dotayush/lucknow/docs/eda_flows.md

# end to end flows: digital, analog, mixed signal

All commands assume `source ~/personal/lucknow/eda/env.sh` first. Tool locations are in `tool_paths.md`.
Process: SkyWater sky130. Wulff's blocks use `sky130B` (a few, like `lelo_*`, use `sky130A`); the LibreLane digital flow
uses `sky130A` (`sky130_fd_sc_hd` cells). Both variants come from the one PDK install.

Status marks: **[verified]** ran on this machine, **[untested]** the recommended route, not run yet.
Re-run every check with `eda/verify.sh <new empty dir>` (add `--gui` for the window checks, `--full` for the long runs).

## 0. setup and sanity

```bash
cd ~/personal/lucknow/eda
./setup.sh                      # idempotent: venv, librelane, make shim
source env.sh
make -v | head -1               # must resolve to .../eda/tools/bin/make
magic --version                 # 8.3.684
./verify.sh /media/ayush/secondary/eda/scratch/verify-$(date +%m%d%H%M)   # a new dir every time, nothing is deleted
```

`make` here is a shim that forces bash. Wulff's Makefiles use `echo -e`; under dash that writes a
literal `-e` into Tcl scripts and DRC reports a false FAIL. Without `env.sh` sourced, use `make SHELL=/bin/bash ...`.
`PDK_ROOT` has no trailing slash on purpose: `//` starts a comment for ngspice older than 40.

## 1. analog (opamps, ADCs, DACs) **[verified]**

Wulff's flow: xschem schematic, ngspice simulation, Magic layout, then DRC, LVS, extraction, post-layout sim.

```bash
cd $AICEX/ip && cicconf clone --https          # fetch the ip repos (once)
cd $AICEX/ip/<block>/work                      # e.g. rply_ex0_sky130nm; work from a copy, see the note below

xschem ../design/<LIB>/<CELL>.sch              # 1. schematic (GUI)
make xsch                                      # 2. netlist -> xsch/<CELL>.spice
magic -d 24BIT -rcfile $PDK_ROOT/sky130B/libs.tech/magic/sky130B.magicrc ../design/<LIB>/<CELL>.mag   # 3. layout (GUI)
make gds                                       # 4. gds/<CELL>.gds
make drc                                       # 5. Magic DRC: "DRC OK"
make cdl; make xlvs                            # 6. LVS vs schematic: "CORRECT" (make cdl first; xlvs without it fails)
make lpe                                       # 7. parasitics -> lpe/<CELL>_lpe.spi
make kdrc                                      # 8. optional: the PDK's KLayout rule deck, report in drc/<CELL>_drc.xml
cd ../sim/<CELL> && MPLBACKEND=Agg make typical     # 9. simulate; etc, mc, tfs for corners. VIEW=Sch or Lay
```

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

View the GDS without a GUI (renders with the PDK's layer colours):

```bash
cat > render.py <<'PY'
import pya
lv = pya.LayoutView(); lv.load_layout(gds, True); lv.load_layer_props(lyp); lv.max_hier(); lv.zoom_fit(); lv.save_image(out, 1200, 800)
PY
klayout -zz -nc -r render.py -rd gds=gds/<CELL>.gds -rd lyp=$PDK_ROOT/sky130B/libs.tech/klayout/tech/sky130B.lyp -rd out=layout.png
```

### What was checked, and what it showed

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

Caveats found while checking:

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

## 2. digital (RTL to GDSII) with LibreLane

LibreLane runs Yosys, OpenROAD, Magic (DRC, GDS), Netgen (LVS) and KLayout from a Nix store on the SSD
(`eda/nixroot`), through `bwrap`; no Docker, no root. `librelane`, `openroad`, `klayout` and `sta` on `PATH` are wrappers
around `nixrun`. Any other tool from that store: `nixrun yosys ...`, `nixrun magic ...`.

```bash
# toolchain check **[verified, native, no terminal needed]**: full flow on a tiny design, ends with "Smoke test passed."
librelane --pdk-root $LIBRELANE_PDK_ROOT --smoke-test

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

# the real run **[verified: clean DRC, LVS, antenna and XOR; timing in core/l0/librelane/RUNS.md]**
core/l0/librelane/run.sh t<N> '{"CLOCK_PERIOD": 44, "DEFAULT_CORNER": "nom_ss_100C_1v60",
  "PNR_SDC_FILE": "<repo>/core/l0/librelane/l0.sdc", "SIGNOFF_SDC_FILE": "<repo>/core/l0/librelane/l0.sdc"}'
# results: <run>/final/{gds,lef,def,nl,sdc,metrics.json} and reports for DRC, LVS, antenna, STA
core/l0/librelane/segments.sh core/l0/librelane/runs/t<N>/final    # delay of each piece of the cycle, from a finished run
core/l0/librelane/screen.sh <new_dir>                              # preview an RTL change by synthesis alone, about a minute
eda/view.sh klayout|openroad|magic <file>                          # look at a result; klayout loads the layer names and the 3D view
```

What `core/l0/librelane` holds and why (details: `RUNS.md`, `TIMING.md` there):

1. `l0_core` is the top (memories outside, ports for fetch and data). A core with no outputs synthesizes to nothing.
2. `l0.sdc` replaces the flow's generic constraint (20% of the clock on every port), which hides the real path. It models the memory as an
   access time and cuts the cycle at the ports.
3. `config.json`: `DESIGN_NAME`, `VERILOG_FILES`, `CLOCK_PORT`, `CLOCK_PERIOD`, utilisation, and the cells kept out of buffering.
4. each run is stored on the SSD and linked into `runs/`; once recorded in `RUNS.md` its folder is deleted (about 1.8 GB each).

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

## 3. mixed signal **[verified up to signoff; see the result below]**

A real analog block (`LELO_GR02`, the oscillator from `lelo_gr02_sky130a`) was placed as a macro in a small digital design
and taken through LibreLane. The working files are in `/media/ayush/secondary/eda/scratch/ms-demo/design`
(`ms_demo.v`, `config.json`, `pdn_cfg.tcl`, the macro `.gds` and `.lef`).

```bash
# 1. analog block, from its work/ directory (so its .magicrc is used): lef and gds
#    load ../design/<LIB>/<CELL>.mag ; lef write <CELL>.lef -hide ; gds write <CELL>.gds
magic -noconsole -dnull export.tcl

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

# 3. digital top with the macro as a blackbox (signal pins only), config.json with MACROS, PDN_MACRO_CONNECTIONS,
#    DIE_AREA, then:
librelane --pdk-root $LIBRELANE_PDK_ROOT --pdk sky130A --run-tag ms config.json
```

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

**Result [verified]:** `ms_demo` (330 x 260 um, 15.9k cells incl. fill, a counter that powers up the oscillator and a
synchroniser that counts its output) closes with every signoff count at 0: Magic DRC 0, KLayout DRC 0, LVS errors 0
(device and net differences 0), antenna 0, routing DRC 0, Magic/KLayout streamout XOR 0, setup and hold violations 0 at a
50 ns clock (worst setup slack +37 ns, hold +0.11 ns). The final GDS has the analog macro inside it.
Everything above is scripted in `eda/ms_demo/run.sh <new_dir>` (about 10 minutes).

Two things that went wrong first, and are worth knowing:

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

## 4. housekeeping

```bash
df -h / /home /media/ayush/secondary   # keep / above 5 GB
```

Run each check in a new directory under `/media/ayush/secondary/eda/scratch`; do not delete run directories to save
space without asking (a standing rule: no recursive deletes).
