dotayush/lucknow/soc/k0/docs/CHIP.md

# k0

A small RISC-V system on a chip (SoC): the l0 core grown into RV32IMA, a memory bus with a
boot rom, ram and three peripherals (uart, clint, plic), and machine interrupts. Still
single-hart, machine mode only, work in progress. The platform deliberately mimics QEMU's
`virt` machine, so software written for that board finds the same devices at the same
addresses.

## Words used below

| word | meaning |
|---|---|
| RV32IMA + Zicsr | base integer set, **M** multiply/divide, **A** atomics, and CSR instructions |
| hart | a hardware thread: one core's instruction stream. k0 has one (`mhartid = 0`) |
| M-mode / U-mode | machine mode, the highest privilege level, and user mode, the lowest. k0 has these two (no supervisor mode) |
| CSR | control and status register, a numbered core register such as `mtvec` |
| trap | the core abandons the current instruction and jumps to a handler. An *exception* is caused by the instruction, an *interrupt* by something outside |
| `mepc` / `mcause` / `mtval` / `mtvec` | where to resume / why / extra detail (bad address or instruction) / where the handler is. `mcause` bit 31 set means interrupt |
| `mie` / `mip` / `mstatus.MIE` | interrupt-enable bits per source / interrupt-pending bits per source / global interrupt enable |
| `mret` | return from a trap handler |
| CLINT | core-local interruptor: a timer and a software-interrupt flag, per hart |
| PLIC | platform-level interrupt controller: collects device interrupt lines, ranks them, hands one to the hart |
| UART | serial port. The register layout is that of the 16550 chip that Linux's 8250 driver expects |
| AMO | atomic memory operation: read, modify, write memory as one indivisible step |
| LR / SC | load-reserved / store-conditional: an optimistic atomic pair, SC fails if something else wrote the word in between |
| MMIO | memory-mapped I/O: device registers accessed with ordinary loads and stores |
| wait state | extra clocks a memory takes to answer; the core freezes meanwhile |
| earlycon | Linux's minimal console driver used before the real serial driver loads |

## At a glance

- RV32IMA + Zicsr, machine and user mode, no C (compressed), no F/D, no Zifencei-specific hardware (`fence.i` works because code and data share ram).
- Single-issue, in order, non-pipelined: one instruction at a time, **one clock per instruction** when memory answers immediately. Loads and stores that hit slow memory, and AMOs (two transfers), take more.
- Fully synchronous apart from async active-low reset (`rst_n`).
- Reset vector `0x0000_1000` (the boot rom).

## Memory map

| range | size | what | access |
|---|---|---|---|
| `0x0000_1000` | 4 KiB (`ROM_WORDS`=1024) | boot rom, preloaded from `memory/bootrom.hex` | read only; fetch and load |
| `0x0200_0000` | 64 KiB | CLINT | word, data port only |
| `0x0C00_0000` | 64 MiB window | PLIC | word, data port only |
| `0x1000_0000` | 256 B | UART (8 registers, repeated) | byte, data port only |
| `0x8000_0000` | `RAM_WORDS` words, default 8192 = 32 KiB | ram | byte/half/word, fetch and data |

Everything else is an access fault. So is: a store to the rom, a non-byte access to the
uart, a non-word or misaligned access to the clint or plic, and fetch from anywhere
but rom or ram. The boot rom holds four instructions: `a1` = `0x807F_0000` (where the device tree goes, low in a 16 MiB ram so it stays out of the way), `a0` = 0 (hart id), jump to `0x8000_0000`; the program
image is preloaded into ram with `RAM_INIT` (a `$readmemh` hex file, one word per line).
This is how every test and program starts: there is no loader or flash yet.

The instruction port and the data port see the *same* ram array, so a store is visible to
the next fetch. `memory/bootrom.hex` is only 4 words; the rest of the rom reads 0.

## Instructions

- **RV32I** as in l0 (see `core/l0/docs/CHIP.md`), plus:
- **M**: `mul mulh mulhsu mulhu div divu rem remu`. The four multiplies are combinational in the ALU, in one clock, through one 33 bit
  signed multiplier. The four divides run in `core/divider.sv`, one quotient bit per clock (restoring divider on the absolute values,
  signs fixed at the end), and hold the core with `stall` like a slow memory: **a divide takes 34 clocks** (1 to load the operands,
  32 for the bits, 1 to retire). Division by zero (`x / 0` = all ones, `x % 0` = x) and overflow (`min int / -1` = min int, remainder 0)
  follow the spec. An interrupt arriving while a divide runs is taken at once: the divide is abandoned (nothing was written) and runs again
  after `mret`, like the atomics. Why: the single-cycle `/` and `%` were 66 ns of a 83 ns ideal-wire path, and the arrays of one
  multiplier and one divider per instruction did not get through logic synthesis (`librelane/RUNS.md`).
- **A**: `lr.w`, `sc.w` and `amoswap/add/xor/and/or/min/max/minu/maxu.w`.
  - Word only (`f3 = 010`); `.aq/.rl` bits are accepted and ignored (nothing reorders).
  - `lr.w` takes a one-word reservation. It is cleared by any store, any `sc`/AMO, a trap and `mret`.
  - `sc.w` succeeds (writes 0 to rd) only if the reservation is on the same address, otherwise writes 1 and stores nothing.
  - An AMO is two bus transfers (read, then write) of one instruction. An interrupt cannot land between them: the whole AMO is restarted after `mret`.
  - Misaligned `sc`/AMO traps even when `sc` would have failed.
  - Reported as a *load* fault for `lr`, a *store* fault for `sc` and the AMOs.
- `wfi` is a no-op (the core keeps running, software loops around it). In user mode it is an illegal instruction.
- `fence` is a no-op; `fence.i` is a no-op that is correct because fetch always sees the latest store.

## Traps

Exceptions use the same codes as l0 (0..7 and 11, see the l0 doc). The extra ones are the
**interrupts**, taken *between* instructions: the interrupted instruction does nothing at all
(no write, no memory transfer, `mepc` is its own pc) and is run again after `mret`.

| `mcause` | interrupt | source |
|---|---|---|
| `0x8000_000B` | machine external | PLIC (`mip.MEIP`, bit 11) |
| `0x8000_0003` | machine software | CLINT `msip` (`mip.MSIP`, bit 3) |
| `0x8000_0007` | machine timer | CLINT `mtime >= mtimecmp` (`mip.MTIP`, bit 7) |

- Priority when several are pending and enabled: external, then software, then timer.
  Exceptions are never masked.
- An interrupt is taken when `mstatus.MIE` is set and `mie & mip` is non-zero.
- Handler address: `mtvec` bit 0 = 0 *direct* (everything to the base), 1 *vectored*
  (interrupts to `base + 4 * code`, exceptions still to the base).
- Trap entry: `mstatus.MPIE = MIE`, `MIE = 0`, `MPP` = the mode the trap came from, the hart enters machine mode.
  `mret`: `MIE = MPIE`, `MPIE = 1`, the hart goes to the mode in `MPP`, `MPP = 00` (user).

### Privilege

- Two modes: machine (`MPP` = `11`) and user (`00`). Reset is machine mode. `MPP` is WARL: any other value reads `00`.
- No physical memory protection: user mode may access everything the machine can (the kernel of a
  no-MMU system trusts its tasks). `pmpaddr*`/`pmpcfg*` are plain storage.
- In user mode, an *illegal instruction* exception is raised by: any csr whose address bits 11:10 are `11`
  *and* is written, any csr of a higher level (address bits 9:8 not `00`: everything `mstatus`, `mtvec`, `mepc`...),
  `cycle/time/instret(h)` unless the matching bit of `mcounteren` is set, `mret` and `wfi`.
- Writing a read only csr (address bits 11:10 = `11`, with a csr instruction that actually writes) is illegal
  in every mode.
- `ecall` from user mode is cause 8, from machine mode 11.
- Interrupts for machine mode are always enabled while the hart is in user mode, whatever `mstatus.MIE` says.
- A trapping or stalled instruction does not retire.
- Inside `control.sv` the one trap that follows the branch compare (a taken branch to a target that isn't 4 byte aligned) is kept
  apart from the others (`trap_early`): the register file and the CSRs a trap does not touch use `trap_early` only, and the late
  decision reaches only `next_pc` and the trap record (`mepc`, `mcause`, `mtval`, `mstatus`). Behaviour is the same, as in l0. The
  branch events of the performance counters read the branch decision (`br_taken`) directly.

## CSRs

As in l0, only the CSRs below exist, each as a named register in `csrfile.sv` (the counters, `pmpcfg*`/`pmpaddr*` and
`mcountinhibit` are described with their own features). Any other address reads 0 and ignores writes, without trapping
(`medeleg`, `mideleg` and `satp` for example). Where behaviour exists:

| CSR | address | notes |
|---|---|---|
| `mstatus` | 0x300 | `MIE` (3), `MPIE` (7) and `MPP` (12:11, `00` or `11`) are writable. Everything else reads 0 |
| `misa` | 0x301 | `0x4010_1101`: RV32, I, M, A, U. Read only |
| `mscratch` | 0x340 | plain storage |
| `mcounteren` | 0x306 | plain storage, bits 0..2 gate `cycle`, `time`, `instret` in user mode |
| `mie` | 0x304 | writable bits 3, 7, 11 only |
| `mtvec` | 0x305 | bit 1 forced to 0; mode = bit 0 |
| `mepc` `mcause` `mtval` | 0x341..0x343 | written on traps |
| `mip` | 0x344 | read only: it *is* the three input wires |
| `mcycle(h)` | 0xB00 / 0xB80 | 64-bit, +1 per clock (includes stall clocks). Writable |
| `minstret(h)` | 0xB02 / 0xB82 | 64-bit, +1 per retired instruction. Writable |
| `cycle(h)` `instret(h)` | 0xC00.. | read-only aliases |
| `time(h)` | 0xC01 / 0xC81 | read from the CLINT's `mtime` |
| `mvendorid` `marchid` `mimpid` `mhartid` | 0xF11..0xF14 | zero, read only |

A write to either half of a 64-bit counter replaces the whole counter.
Writes to read-only CSRs are dropped without trapping.

## Devices

### UART (`0x1000_0000`)
16550A: 16550 register layout with a 16 byte receive and transmit FIFO, enabled by `FCR` bit 0
(`FCR` is the write side of register 2; FIFO = first-in first-out queue). With the FIFOs off it behaves as a 16450,
one byte each way. Use `compatible = "ns16550a"` in a device tree. Byte accesses only. Fixed 8N1 at
`clk / UART_CLKS_PER_BIT` (default 8, minimum 4); the divisor latches (`DLAB`) are stored but
do not change the baud rate.

| offset | read | write |
|---|---|---|
| 0 | `RBR` received byte (clears DR) | `THR` send a byte; with FIFOs off dropped if still sending, with FIFOs on queued (16 deep) |
| 1 | `IER` | `IER`: bit 0 rx data, 1 THR empty, 2 line status |
| 2 | `IIR`: 0x01 none, 0x06 line status, 0x04 rx data (at the trigger level), 0x0C character timeout, 0x02 THR empty (reading clears 0x02); bits 7:6 = 11 with FIFOs on | `FCR`: bit 0 FIFO enable, 1 clear rx, 2 clear tx, 7:6 rx trigger 1/4/8/14 |
| 3, 4, 7 | `LCR`, `MCR`, `SCR` stored only | |
| 5 | `LSR`: bit 0 DR (rx FIFO not empty), 1 overrun, 3 framing, 5 THRE (tx FIFO empty), 6 TEMT (nothing queued or shifting) (OE, FE clear on read) | |
| 6 | `MSR` = 0 | |

An overrun keeps the unread byte and drops the new one. Software has to drain the receiver
within one byte time. `ECHO=1` prints transmitted bytes in simulation. Interrupt is PLIC source 10.

### CLINT (`0x0200_0000`, sifive/qemu layout, one hart)
| offset | register |
|---|---|
| `0x0000` | `msip`: bit 0 is the software interrupt |
| `0x4000` / `0x4004` | `mtimecmp` low / high (resets to all ones: no timer interrupt until set) |
| `0xBFF8` / `0xBFFC` | `mtime` low / high, a 64-bit counter of clocks since reset (writable) |

Timer interrupt is level: high while `mtime >= mtimecmp`. Clear it by moving `mtimecmp` forward.

### PLIC (`0x0C00_0000`, sifive/qemu layout, one context = this hart's M-mode)
| offset | register |
|---|---|
| `0x000000 + 4n` | priority of source n (3 bits, 0 = never interrupts), n = 1..31 |
| `0x001000` | pending bits (read only) |
| `0x002000` | enable bits |
| `0x200000` | threshold: only priorities strictly above it interrupt |
| `0x200004` | read = claim (id of the best pending source, 0 if none), write = complete (write the id back) |

Sources are level-triggered. A claimed source stays blocked until completed, so a device that
is still asserting does not re-interrupt before the handler is done. Highest priority wins,
lowest id on a tie. Only the UART is connected (source 10).

## Bus and timing

`bus.sv` decodes addresses and also owns the timing model.

- Fetch port and data port are independent request/ready channels. The core presents an
  address and waits for `ready`; the transfer completes on the clock edge where both are high.
- `FETCH_WAIT` and `DATA_WAIT` add that many clocks to every *new* request, to test the core
  against slow memory. While waiting the whole core freezes: pc, registers, CSRs and memory
  are untouched, so an instruction happens exactly once.
- Device registers with side effects (UART `RBR/LSR/IIR`, PLIC claim) act only on the clock
  where the access completes, never on waiting clocks.
- Ram and rom reads are combinational; ram writes land on the completing edge.

## Files

| file | role |
|---|---|
| `core/control.sv` | the core: datapath, A-extension sequencing, interrupts, stalls, trap selection. Loads, stores and `jalr` compute `rs1 + imm` on their own adder, not through the alu |
| `core/decoder.sv` `alu.sv` `regfile.sv` `signext.sv` | as in l0; the ALU also does the four multiplies |
| `core/divider.sv` | div, divu, rem, remu: one bit per clock, started and held by `control.sv` through `stall` |
| `core/csrfile.sv` | CSRs, interrupt pending/enable logic, 64-bit counters |
| `core/cache.sv` | despite the name, a plain ram/rom array with a second read-only fetch port |
| `core/clint.sv` `plic.sv` `uart.sv` | the devices |
| `bus.sv` | address decode, wait states, device wiring |
| `core/soc.sv` | core + bus: ports `clk`, `rst_n`, `uart_rx`, `uart_tx` |
| `core/shared.sv` | package `isa_shared`: opcodes, ALU ops, CSR addresses, trap codes |
| `compile.f` | file list for iverilog |

## Verification

- `tests/test_<module>.sv` per unit (alu, bus, clint, control, csrfile, decoder, memory,
  plic, regfile, signext, uart) plus `test_amo_faults.sv`.
- `riscv/run.sh`: official riscv-tests rv32ui (including `fence_i`), rv32mi (including
  `illegal`, `instret_overflow`), rv32um and rv32ua (suite cloned into `core/l0/riscv-tests` on first use; needs
  `riscv32-unknown-elf-gcc`, `source eda.sh` puts it on `PATH`). Works with wait states, 2 cycles per fetch and 3 per data access:
  `RV_IFLAGS="-Ptest_riscv.FETCH_WAIT=2 -Ptest_riscv.DATA_WAIT=3" ./riscv/run.sh`.
- `programs/run.sh <name>`: bare-metal assembly programs run through the uart, output compared with `<name>.expect`:
  `hello` (the default), `timer` (CLINT interrupts, direct and vectored), `irqatomic` (AMOs hit by
  interrupts are neither lost nor repeated), `uartrx` (typed bytes arrive by PLIC interrupt, echoed upper case), `umode`.
  Slow memories: `IFLAGS="-Ptest_hello.FETCH_WAIT=2 -Ptest_hello.DATA_WAIT=3" ./programs/run.sh irqatomic`. The uart input follows
  with 2 bit times between bytes; `IFLAGS="-Ptest_hello.RX_GAP=0"` sends them back to back, and with slow memories the handler can't
  keep up with a uart in 16450 mode (that program does not enable the fifo): bytes are lost (overrun), which is what the hardware should do.
- Not run: `breakpoint` (debug triggers) and `ma_data` (hardware misaligned access).

## Performance counters (Zihpm)

Besides `cycle`, `time` and `instret`, eight event counters: `mhpmcounter3..10` (64 bit, high halves at
`mhpmcounter3h..`), each counting the one event named by its `mhpmevent3..10` register. Event 0 counts
nothing, numbers above 15 read back as 0. `mcountinhibit` stops counters: bit 0 cycle, bit 2 instret,
bits 3 to 10 the event counters. Counters 11 to 31 are not there (read zero, writes ignored).

| event | counts | | event | counts |
|---|---|---|---|---|
| 1 | loads retired | | 9 | clocks waiting for data (bus not ready) |
| 2 | stores retired | | 10 | multiply and divide retired |
| 3 | conditional branches taken | | 11 | atomics retired |
| 4 | conditional branches not taken | | 12 | CSR instructions retired |
| 5 | jumps retired (`jal`, `jalr`) | | 13 | clocks in user mode |
| 6 | exceptions taken | | 14 | access faults taken (bus or PMP) |
| 7 | interrupts taken | | 15 | misaligned access traps |
| 8 | clocks waiting for the instruction | | | |

- At reset counters 3 to 10 count events 1 to 8 (loads, stores, taken, not taken, jumps, exceptions,
  interrupts, fetch wait clocks), and `mcounteren` allows user mode to read every counter. Both are
  conveniences: the Linux M-mode build never writes `mcounteren`, so without them user programs could not
  read the counters. Reprogram the events with a `csrw` in machine mode.
- `hpmcounter3..` (0xC03..) are the user mode read-only copies, gated per counter by `mcounteren`.
- Counts are global: whoever runs between two reads is included, the kernel too.
- Test: `programs/hpm.S` counts a known workload and checks inhibit, the 64 bit carry and user access.

## PMP (physical memory protection)

Eight regions, checked on every instruction fetch and data access (`core/pmp.sv`, registers in
`csrfile.sv`: `pmpcfg0`/`pmpcfg1`, `pmpaddr0`..`pmpaddr7`; entries 8 to 15 read as zero).

| `pmpcfg` bit | meaning |
|---|---|
| 0 R, 1 W, 2 X | read, write, execute allowed |
| 4:3 A | 0 off, 1 TOR (top of range: from the previous entry's address up to this one), 2 NA4 (one 4 byte word), 3 NAPOT (naturally aligned power of two, size from the trailing ones of `pmpaddr`) |
| 7 L | locked: the entry also binds machine mode, and its `pmpcfg` byte and `pmpaddr` (and the `pmpaddr` below a locked TOR) ignore writes until reset |

- The lowest numbered matching entry decides. User mode needs a match with the right permission, and fails
  if nothing matches. Machine mode passes if nothing matches or the match is not locked.
- A failing fetch is instruction access fault (1), a failing load or `lr` is load access fault (5), a
  failing store, `sc` or amo is store access fault (7). The access is not sent to the bus at all.
- Granularity is 4 bytes. `W` without `R` is reserved and `W` is dropped on write.
- Linux in M-mode only programs entry 0 as "everything, rwx" (`head.S`) so it runs, and protects nothing.
  Making user tasks unable to write kernel memory needs kernel support that sets regions per task.
- Test: `tests/test_pmp.sv` (the checker) and `programs/pmp.S` (user mode against regions, locked entries).

## Not implemented

- S-mode, `medeleg`/`mideleg`, `sret`, `mstatus` bits other than `MIE`/`MPIE`/`MPP` (`MPRV`, `SUM`...).
- MMU, `satp`, page tables, `sfence.vma`; PMP entries 8 to 15 and `mstatus.MPRV` (see PMP).
- C (compressed) and F/D; hardware misaligned loads/stores (they trap).
- Debug module and triggers, `mcountinhibit`, `mconfigptr`.
- More than one hart, more than one PLIC context, per byte error flags in the UART FIFO.
- Any storage device, timer other than CLINT, interrupt sources other than the UART.
- Ram is small by default (32 KiB). Raise `RAM_WORDS` for anything larger.

## Running Linux

k0 boots a no-MMU Linux 6.12 (M-mode kernel build, `CONFIG_RISCV_M_MODE`, user tasks in user mode)
to a busybox shell on the uart. Everything for this is in `linux/` and `sim/`; how to build and run it is in
`LINUX.md`, the plan and findings in `PLAN.md`.

- `sim/build.sh` builds a Verilator model of the soc with 16 MiB of ram. `sim/obj/Vsoc` loads binary
  images into ram, drives the uart receive line from a file and prints what the uart sends. Roughly
  1.7 million instructions per second of host time.
- `linux/build.sh` builds the kernel, the device tree (`k0.dts`) and a small freestanding `init` with a
  shell (`init/init.c`, a bFLT binary, no libc). `linux/run.sh` boots it, `linux/test.sh` boots it and types commands.
  `linux/buildroot/` builds a busybox and uClibc-ng root filesystem, `linux/busybox.sh` embeds it, `linux/shell.sh` puts
  your terminal on the uart, `linux/qemu.sh` runs the same image on QEMU as a reference.
- The kernel needs: `a0` = hart id and `a1` = device tree pointer (the boot rom does that), ram at
  `0x8000_0000`, the kernel linked there, the uart as `ns16550a`, CLINT, PLIC, `timebase-frequency`
  equal to the clock (`mtime` counts clocks). Misaligned loads/stores trap and are emulated by the kernel.
