dotayush/lucknow/core/l0/librelane/RUNS.md

# l0_core LibreLane runs

One row per try that finished or taught something: settings, results, outcome. The model behind the numbers is in
`TIMING.md`. `results/t<N>.metrics.json` is the flow's final `metrics.json` for each finished run. Run folders are
about 1.8 GB each, live under `$EDA/scratch/l0-try<N>/runs/t<N>`, are linked as `runs/t<N>` while they exist,
and are deleted once recorded here (`run.sh` starts a run, `segments.sh` measures one, `screen.sh` previews an RTL change).

Common to every run: design `l0_core`, sky130A, `sky130_fd_sc_hd`, LibreLane 3.0.16, full flow, flip-flops 1408
(register file 1024, 11 CSRs 352, pc 32). `FP_CORE_UTIL` 40 and `PL_TARGET_DENSITY_PCT` 50 unless stated; die 254,154 um2
(about 504 um square). Slack is setup slack at signoff on extracted wires; `ss` is `max_ss_100C_1v60`, `tt` is
`nom_tt_025C_1v80`. Cell area is placed standard cells including taps, repair and clock buffers. Signoff = Magic DRC,
KLayout DRC, routing DRC, LVS, antenna and layout XOR; "clean" means all six are 0. Hold violations are 0 in every finished run.

## Settings

| try | question | change from the previous row | clock (ns) | optimized corner | constraints |
|---|---|---|---|---|---|
| t3 | does the trimmed core build | CSR file trimmed to 11 registers | 50 | tt | fallback SDC |
| t4 | do delay cells cost timing | `EXTRA_EXCLUDED_CELLS`: `clkdlybuf*`, `dlymetal*` | 50 | tt | fallback SDC |
| t5 | does the optimized corner matter | slow corner | 50 | ss | fallback SDC |
| t6 | does a tighter clock help | clock 38 | 38 | ss | fallback SDC |
| t7 | is the wire layer estimate the gap | `SIGNAL_WIRE_RC_LAYERS` met1, met2 | 38 | ss | fallback SDC |
| t8 | how far does the resizer go | clock 29 | 29 | ss | fallback SDC |
| t9 | does a setup margin close it | clock 36, setup margins 7 ns | 36 | ss | fallback SDC |
| t11 | which block owns the path | `SYNTH_HIERARCHY_MODE: keep`, `ERROR_ON_UNMAPPED_CELLS: false` | 36 | ss | fallback SDC |
| t14 | realistic constraints | `l0.sdc` (memory 4 ns, budgets 6 and 10 ns), default margins | 44 | ss | `l0.sdc` |
| t16 | does shorter wiring help | t14 plus `FP_CORE_UTIL` 55, density 65 | 44 | ss | `l0.sdc` |
| t17 | where do the hold buffers come from | t14 repeated | 44 | ss | `l0.sdc` |
| t18 | does splitting the trap help | RTL: trap split into early and late parts, t17 settings | 44 | ss | `l0.sdc` |
| t19 | does a dedicated address adder help | RTL: `rs1 + imm` for loads, stores and `jalr` on its own adder, t18 settings | 44 | ss | `l0.sdc` |
| t20 | does taking decode out of the register read and the address help | RTL: register file reads `instruction[19:15]` and `[24:20]` (not the decoder's gated `rs1`/`rs2`), `dmem_addr` is the adder output without opcode selection, adder offset from the instruction bits, t19 settings | 44 | ss | `l0.sdc` |
| t21 | (IHP SG13G2, unscaled budgets) | the same core on IHP with the sky130 nanoseconds in `l0.sdc` | 25 | slow | `l0.sdc` |
| t24 | the same core on IHP | `PDK_FAMILY=ihp-sg13g2`, `l0.sdc` budgets scaled by FO4 | 33.1 | slow | `l0.sdc` |
| t25 | the same core on gf180mcu | `PDK_FAMILY=gf180mcu`, `l0.sdc` budgets scaled by FO4 | 138.8 | ss | `l0.sdc` |
| t26 | how far below 44 ns does t20 go | clock 40, t20 RTL and `l0.sdc` | 40 | ss | `l0.sdc` |
| t27 | does a registered reset release fix the reset timing | `rst_n` input delay 1.5 ns (scaled by FO4) instead of 0, t20 at 44 | 44 | ss | `l0.sdc` variant |
| t28 | can the address segment have a longer budget | `B_PC_OUT` 4 ns and `B_LOAD` 9 ns instead of 6 and 10, t20 at 44 | 44 | ss | `l0.sdc` variant |
| t29 | does keeping the memory error out of the write enables help | RTL: `mem_fault` kept apart from `trap_early`, enters the register file and csr write enables last; t20 settings | 44 | ss | `l0.sdc` |
| t30 | what period does t29 close at with a rebalanced budget | t29 RTL, `rst_n` delay 1.5 ns, `B_PC_OUT` 4 ns, `B_LOAD` 10 ns | 42 | ss | `l0.sdc` variant |
| t31 | the same, one ns lower | t30 at 41 ns | 41 | ss | `l0.sdc` variant |
| t32 | does the rebalanced budget close at 41 ns | t30 with `B_PC_OUT` 4.25 ns (adopted in `l0.sdc`), 41 ns | 41 | ss | `l0.sdc` |
| t33 | one ns lower | t32 at 40 ns | 40 | ss | `l0.sdc` |

"Fallback SDC" is LibreLane's generic one: 20% of the clock as input and output delay on every port (`TIMING.md` section 2).
Not in the table: t1 (the core with memories inside, failed at floorplan: Yosys removed everything, `control` has no outputs),
t2 (4096-entry CSR array: 131,072 flops, stopped, Yosys too slow), t10 (failed in the unmapped-cell check on `$paramod`
module names), t12 and t13 (killed minutes in: parameter sweeps), t15 (`FP_CORE_UTIL` 65: `DPL-0036`, detailed placement ran
out of legal sites after the resizer added about 35% cell area).

## Results

| try | cell area (um2) | util | slack ss (ns) | slack tt (ns) | slack ff (ns) | violating paths | hold buffers | power (mW) | signoff | outcome |
|---|---|---|---|---|---|---|---|---|---|---|
| t3 | 135,683 | 0.57 | -10.22 | +11.20 | +17.34 | 4113 | 1312 | 2.76 | clean | first complete run |
| t4 | 129,116 | 0.54 | -8.31 | +13.06 | +18.58 | 3844 | 1315 | 2.76 | clean | area -5%, ss +1.9 ns |
| t5 | 129,074 | 0.54 | -7.91 | +13.13 | +18.64 | 3799 | 1315 | 2.76 | clean | corner did not matter |
| t6 | 129,234 | 0.54 | -8.17 | +8.62 | +13.25 | 4106 | 1315 | 3.64 | clean | tighter clock, same miss |
| t7 | 129,219 | 0.54 | -8.02 | +8.75 | +13.35 | 4106 | 1315 | 3.63 | clean | wire layer was not the cause |
| t8 | 133,320 | 0.56 | -7.36 | +5.61 | +9.48 | 4137 | 1315 | 4.78 | clean | resizer pushed hard, +3% area |
| t9 | 131,808 | 0.56 | -3.89 | +9.83 | +13.65 | 2592 | 1315 | 3.85 | clean | margin helped |
| t11 | 132,989 | - | -2.74 | +10.02 | +13.78 | 2878 | 1360 | 3.78 | clean | critical endpoint is in `csrfile_inst` |
| t14 | 120,960 | 0.51 | -4.43 | +3.62 | +4.25 | 331 | 1277 | 2.96 | clean | first run with real constraints |
| t16 | 119,304 | 0.69 | -5.67 | +3.67 | +4.25 | 1066 | 1286 | 2.87 | clean | die 186,915 um2 (-26%), wires -8%, slack 1.2 ns worse |
| t17 | 120,960 | 0.51 | -4.43 | +3.62 | +4.25 | 331 | 1277 | 2.96 | clean | bit-identical to t14: the flow is deterministic |
| t18 | 119,130 | - | -4.57 | +3.46 | +4.13 | 78 | 1302 | 2.96 | clean | targeted segments -6.5 ns, limiter is elsewhere |
| t19 | 121,800 | 0.51 | -2.38 | +3.79 | +4.37 | 20 | 1321 | 2.99 | clean | limiting segment -2.2 ns, area +2.2% |
| t20 | 122,226 | 0.51 | -0.01 | +3.59 | +4.29 | 1 | 1345 | 3.07 | clean | decode out of the register read: +2.4 ns slack, area +0.3%, one path 11 ps short |
| t24 (IHP) | 185,254 | - | +1.10 | +3.09 | +3.49 | 0 | - | 3.42 | clean | other PDK, see TIMING.md section 6 |
| t25 (gf180mcu) | 371,327 | - | +2.78 | +12.66 | +14.63 | 0 | - | 13.3 | clean (no KLayout DRC) | other PDK, see TIMING.md section 6 |
| t26 | 122,271 | 0.51 | -3.73 | +3.61 | +4.29 | 41 | 1345 | 3.38 | clean | 40 ns does not close under `l0.sdc`: the address budget is T - 24 ns |
| t27 | 122,213 | 0.51 | +0.01 | +3.60 | +4.29 | 0 | 1342 | 3.07 | clean | `rst_n` delay: signoff closes (not a change in structure), hold buffers do not move |
| t28 | 122,226 | 0.51 | -1.01 | +1.59 | +2.29 | 39 | 1345 | 3.07 | clean | `B_LOAD` 9: `dmem_err` to flop, not the address, is what fails |
| t29 | 122,227 | 0.51 | +1.48 | +3.59 | +4.29 | 0 | 1331 | 3.06 | clean | memory error last: +1.5 ns slack at 44 ns (from -0.01), address segment -1.5 ns, area unchanged |
| t30 | 122,217 | 0.51 | -0.13 | +1.58 | +2.28 | 5 | 1328 | 3.20 | clean | all five violations are `pc` to `imem_addr`: `B_PC_OUT` 4 ns is 0.13 ns too small |
| t31 | 122,217 | 0.51 | -0.13 | +1.58 | +2.28 | 5 | 1328 | 3.28 | clean | the same five paths as t30: the address path meets its budget at 41 ns |
| t32 | 122,217 | 0.51 | +0.15 | +1.84 | +2.53 | 0 | 1328 | 3.28 | clean | **closes at 41 ns**; minimum period about 40.85 ns (24.5 MHz at ss) |
| t33 | 122,215 | 0.51 | -0.61 | +1.82 | +2.53 | 4 | 1328 | 3.36 | clean | 40 ns: `imem_data` to `dmem_addr[31]` is 0.6 ns short |

Path segments, slow corner, extracted wires, no I/O delays (`segments.sh`):

| try | pc to `imem_addr` | `imem_data` to `dmem_addr` | `imem_data` to flop | `dmem_rdata` to flop | flop to `dmem_addr` | flop to flop |
|---|---|---|---|---|---|---|
| t9 | 4.8 | 21.4 | 32.6 | 9.5 | 16.9 | 27.8 |
| t11 | 3.5 | 20.9 | 31.6 | 9.0 | 15.4 | 26.3 |
| t14 = t17 | 3.3 | 23.7 | 35.8 | 6.8 | 19.5 | 31.7 |
| t16 | 3.2 | 25.0 | 36.4 | 6.1 | 19.1 | 30.6 |
| t18 | 3.6 | 23.6 | 29.3 | 6.8 | 17.6 | 23.0 |
| t19 | 3.0 | 21.4 | 30.1 | 6.6 | 15.5 | 24.8 |
| t20 | 3.2 | 18.9 | 28.3 | 8.0 | 16.5 | 25.8 |
| t24 (IHP) | 1.7 | 11.0 | 17.9 | 5.3 | 7.8 | 14.7 |
| t25 (gf180mcu) | 9.1 | 47.2 | 71.8 | 21.5 | 34.0 | 54.8 |
| t26 to t28 | 3.2 | 18.8 to 19.0 | 28.3 | 8.0 | 16.5 | 25.8 | (same RTL as t20: only the constraints changed) |
| t29 | 3.2 | 17.4 | 24.2 | 6.9 | 15.8 | 22.6 |
| t30, t31 | 3.2 | 17.3 | 24.3 | 6.9 | 15.7 | 22.6 |
| t32, t33 | 3.2 | 17.3 to 17.4 | 24.2 to 24.3 | 6.9 | 15.6 to 15.7 | 22.6 to 22.7 |

## What was learned

1. **The flow's default I/O constraint hides the real path.** It puts 20% of the clock on every memory input. Without it the t9 path
   has slack. `l0.sdc` models the memory as an access time and cuts the cycle at the ports.
2. **The wire estimate during place and route is about 9 ns too optimistic on the worst path** (cells 23.6 ns, PnR estimate 24.7 ns,
   extracted 32.6 ns, from t9). Moving the optimized corner (t5), the clock (t6, t8), the wire layer (t7) or the fill (t16) did not close it.
3. **A flat 4096-entry CSR array is not buildable** (t2) and 11 named CSRs pass riscv-tests; the same applies to FPGA (`../fpga/FPGA.md`).
4. **Banning slow delay cells as buffers** gave 5% less area and about 2 ns (t4). Kept in `config.json`.
5. **The longest path under the fallback SDC ended in the CSR file** (t11, hierarchy kept): decode 2.4 ns, register read 7.7, ALU 8.4,
   control selection 5.9, buffers 3.8, CSR mux 4.9 = 31.6 ns.
6. **Splitting the trap into an early part and a late branch-only part took 6.5 ns off `imem_data` to flop and 8.7 ns off flop to flop** (t18),
   matching the ideal-wire preview (`screen.sh`) exactly. It does not move signoff slack at 44 ns, because under `l0.sdc` the limiting path is
   the cycle through memory twice, whose biggest piece, `imem_data` to `dmem_addr` (decode, register read, ALU add) at 23.6 ns, is untouched.
7. **A dedicated `rs1 + imm` adder** for loads, stores and `jalr` (t19) took 2.2 ns off `imem_data` to `dmem_addr` (preview 2.1 ns ideal, predicted 2.7 with wires),
   moved signoff slack at 44 ns from -4.57 to -2.38 ns and violating paths from 78 to 20, for +2.2% cell area. `imem_data` to flop and flop to flop got 0.8 and 1.8 ns
   worse in the routed result while the ideal-wire preview had them better: placement differences of about 1 to 2 ns are not predicted by the preview.
   The limiting path is still `imem_data` to `dmem_addr`, and its slack falls about 0.5 ns per address bit (bit 31 -2.38, bit 30 -1.91, bit 29 -1.39 ns): a carry chain that is
   close to ripple. (Yosys does not look at the clock period, so the adder is not sized to the target; the adder types were measured in t20: not the lever.)
8. **Decode was in front of the register read** (t20). The decoder zeroes `rs1` and `rs2` for instructions that do not use them, and the register file read that
   gated index, so a 134 fanout decode net (4 ns) sat between `imem_data` and the read mux. Reading the fields straight from the instruction took
   `imem_data` to `dmem_addr` from 15.4 to 11.4 ns in the ideal-wire preview and from 21.4 to 18.9 ns routed (predicted 3 ns gain, got 2.5), signoff slack from -2.38 to -0.01 ns, area +0.3%.
   `SYNTH_ADDER_TYPE` was measured first and is not a lever: `YOSYS` and `FA` give identical netlists (15.43 ns), `CSA` 24.8 and `RCA` 39.5, so the default adder is already the fast one
   and the carry chain was not the problem. Two companion edits were made in the same run and not measured apart: the address no longer has an opcode select
   (preview 15.43 to 15.35 ns on its own, 1.4 to 1.8 ns on the flop segments), and the adder offset comes from the instruction bits (preview +0.4 ns, no gain on its own).
   Flop to flop got 1.0 ns worse routed, the same 1 to 2 ns placement noise as in item 7.
9. **Hold buffers are a margin artifact** (t17, reports before repair). 1271 of the 1277 sit between a flop output and a mux input on the
   register-file and CSR hold loops, which do not violate: worst hold slack before repair is +0.062 ns (fast corner), +0.70 ns on a sample slow-corner loop.
   The repair tops each up to the 0.10 ns margin (`PL_RESIZER_HOLD_SLACK_MARGIN`, over 0.25 ns clock uncertainty). A policy question for a
   real chip; irrelevant for an FPGA.
10. **The budgets are a partition, and one segment was hiding behind them** (t26 to t28). Under `l0.sdc` the three pieces of a cycle each have a fixed budget; spare time on one
   cannot be lent to another. t26 shows the address segment has `T - B_PC_OUT - 2 T_MEM - B_LOAD` = 20 ns at 44 ns, and 16 ns at 40, so 40 ns fails by 3.7 ns (predicted 2 to 4).
   t28 moved 3 ns of budget to the address (`B_PC_OUT` 4, `B_LOAD` 9) and got -1.0 ns, not the +3 predicted: the path that fails is `dmem_err` to flop (11.1 ns routed,
   through the trap fan-out tree to about 1,400 flops; each of the 7 stages drives 18 to 55 loads, 1.3 to 2.0 ns a stage), which needs the 10 ns `B_LOAD` and
   which `segments.sh` does not list (the preview does). `pc` to `imem_addr` has about 2.8 ns spare of its 6. With `B_PC_OUT` 4 and `B_LOAD` 10 the address budget is T - 22 ns,
   so the period floor of the t20 netlist is about 42 ns.
11. **`rst_n` with a delay of 1.5 ns closes** (t27, +0.01 ns, 0 violating paths instead of -0.01 and 1) and the area and hold buffers are the same: the 1345 hold buffers are not
   caused by the reset (prediction that they would drop was wrong). It is a different constraint, not a faster design.
12. **The memory error is the latest of the early traps, and structure told the synthesizer** (t29). Yosys treats every input as arriving at time zero, so `dmem_err` sat deep in the
   cones of the register file and csr write enables. `mem_fault` (a load or store the memory refuses, with nothing earlier trapping) is now a separate term that is
   ANDed in last (register file `reg_write`, csr write enables), the same method as the branch split (item 6). The preview predicted -0.7 ns on `dmem_err` to flop,
   -1.7 ns on `imem_data` to flop and -2.5 ns flop to flop; the routed result was larger than predicted: address segment 18.9 to 17.4 ns, `imem_data` to flop 28.3 to 24.2,
   flop to flop 25.8 to 22.6, signoff slack at 44 ns from -0.01 to +1.48 ns, with the same area. riscv-tests 53/53.
13. **With `B_PC_OUT` 4 ns the next limit is `pc` to `imem_addr`** (t30, t31): the five violations are the same paths at 42 and at 41 ns, 0.13 ns over a budget that does not depend on the clock.
   `B_PC_OUT` 4.25 ns closes at 41 ns (t32, +0.15 ns, no violations, signoff clean). 40 ns (t33) is 0.61 ns short on `imem_data` to `dmem_addr[31]`.
   So the t29 netlist closes at 41 ns, 24.5 MHz at the slow corner, 25.5 MHz at the typical one (period 41 - 1.84). These budgets are in `l0.sdc` now; t14 to t31 used the old ones
   (`B_PC_OUT` 6 ns, `rst_n` delay 0), so `run.sh` does not reproduce them.
14. **`l0.sdc` gave `rst_n` an input delay of 0** against a clock that reaches the flops 1.13 ns late: 403 removal violations before repair (worst -1.59 ns),
   all `rst_n` to a flop reset pin. A fair constraint gives the reset the host's registered release time. Not changed, so t14 to t18 stay comparable. Item 11 (t27) tried a delay of 1.5 ns: it closes, so the constraint is a fair one to adopt.
15. **Fill is not the timing lever** (t16): 55% fill gave a die 26% smaller and wires 8% shorter, and slack 1.2 ns worse. 65% does not place (t15).
16. **A hard target costs time**: the post-clock-tree timing repair was 40 of t9's 56 minutes. With `l0.sdc` it is short. Synthesis through clock tree is
    about 2 minutes; signoff checks (stream-out, DRC, LVS, XOR) about 3.5.
17. **The layout is manufacturable** in every finished run. Only slow-corner timing is open.

## Next candidates

l0 is paused here (user decision, 41 ns closed at the slow corner). What is left, in the order it would matter:

- `imem_data` to `dmem_addr[31]` (17.3 ns routed) is the limit at 40 ns; the carry chain of the address adder and the register read mux are all that is in it now.
- `imem_data` to flop (24.2 ns) and flop to flop (22.6 ns) have 6 ns or more of slack against their budgets; they matter below about 38 ns.
- A registered memory interface (removes the fetch from the chain) is a k0-level decision; see `TIMING.md` section 5.
- The 1,328 hold buffers (item 9) are a margin policy question, not a design one.

## Reproducing

`run.sh` fills in the slow corner, the delay cell exclusions and `l0.sdc` from the PDK in `.env`. Tries t3 to t11 used the flow's fallback SDC and t14 to t31 an older `l0.sdc` (`B_PC_OUT` 6 ns, `rst_n` delay 0); `run.sh` no longer starts such a run.

```bash
core/l0/librelane/screen.sh <new_dir>                 # preview an RTL change, about a minute
core/l0/librelane/run.sh t<N> '{"CLOCK_PERIOD": 41}'   # slow corner, delay cells and l0.sdc come from run.sh and .env (PDK_FAMILY)
core/l0/librelane/segments.sh core/l0/librelane/runs/t<N>/final
```
