dotayush/lucknow/assets/photo.png

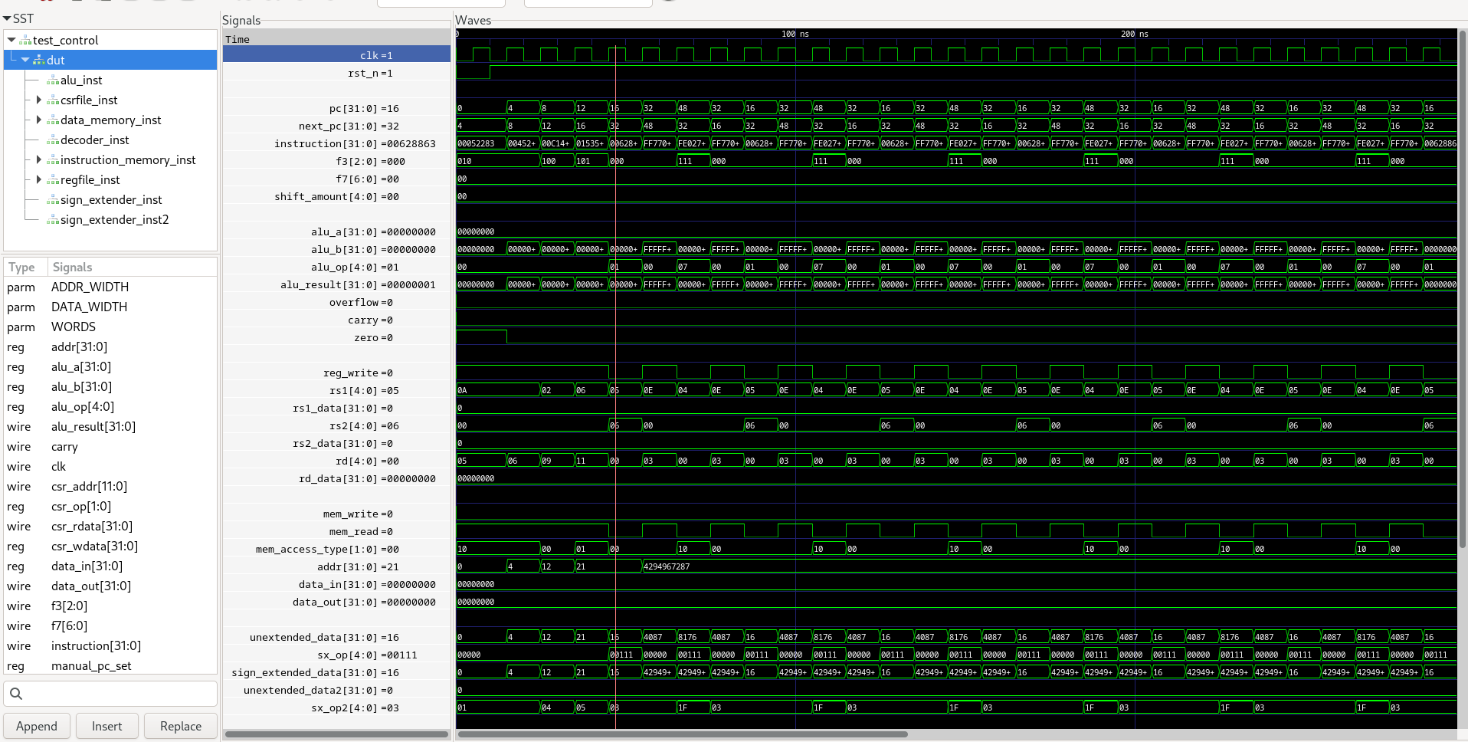
assets/photo.png
