dotayush/lucknow/core_l1/src/signext.sv

`ifndef ISA_SHARED_IMPORT
  `define ISA_SHARED_IMPORT
  import isa_shared::*;
`endif

module signext #(parameter DATA_WIDTH = 32) (
    input logic [DATA_WIDTH-1:0] unextended_data, // '0 || whatever bits = 32 bits which can then be extracted
    input logic [4:0] sx_op,

    output logic [DATA_WIDTH-1:0] sign_extended_data
);

  always @* begin
    case (sx_op)
      // general purpose
      SX_1100: sign_extended_data = {{(DATA_WIDTH-1-11){unextended_data[11]}}, unextended_data[11:0]}; // 12 bit immediate signed extension
      SX_2000: sign_extended_data = {{(DATA_WIDTH-1-20){unextended_data[20]}}, unextended_data[20:0]}; // 21 bit immediate signed extension
      SX_1900: sign_extended_data = {{(DATA_WIDTH-1-19){unextended_data[19]}}, unextended_data[19:0]}; // 19 bit immediate signed extension

      // signed extensions
      SX_0700: sign_extended_data = {{(DATA_WIDTH-1-7){unextended_data[7]}}, unextended_data[7:0]}; // byte
      SX_1500: sign_extended_data = {{(DATA_WIDTH-1-15){unextended_data[15]}}, unextended_data[15:0]}; // half-word
      SX_3100: sign_extended_data = unextended_data; // word
      SX_1200: sign_extended_data = {{(DATA_WIDTH-1-12){unextended_data[12]}}, unextended_data[12:0]}; // 13 bit immediate signed extension

      // unsigned extensions
      SXU_0700: sign_extended_data = {{(DATA_WIDTH-1-7){1'b0}}, unextended_data[7:0]}; // byte
      SXU_1500: sign_extended_data = {{(DATA_WIDTH-1-15){1'b0}}, unextended_data[15:0]}; // half-word
      SXU_0400: sign_extended_data = {{(DATA_WIDTH-1-4){1'b0}}, unextended_data[4:0]}; // 5 bit unsigned extension (for shift amount)
      default: sign_extended_data = '0;
    endcase
  end


endmodule
