dotayush/lucknow/soc/k0/tests/test_hello.sv

`timescale 1ns/1ps

// runs a program that prints over the uart and checks the characters on the serial line.
// run from soc/k0 through ./programs/run.sh, which builds the image.
module test_hello;

  parameter IMAGE = "";
  parameter EXPECTED = "hello, lucknow\n";
  parameter int LENGTH = 15; // characters in EXPECTED
  parameter int CLKS_PER_BIT = 8;
  parameter MAX_CYCLES = 100000;
  parameter int FETCH_WAIT = 0;
  parameter int DATA_WAIT = 0;
  parameter RX_STRING = ""; // bytes typed on the serial line, one after the other
  parameter int RX_LENGTH = 0; // characters in RX_STRING
  parameter int RX_DELAY = 1000; // clocks before the first byte
  parameter int RX_GAP = 2; // idle bit times between bytes

  localparam real CLK_HALF_PERIOD = 5.0;

  reg clk;
  reg rst_n;
  reg uart_rx;
  wire uart_tx;

  soc #(
    .RAM_INIT(IMAGE),
    .FETCH_WAIT(FETCH_WAIT),
    .DATA_WAIT(DATA_WAIT),
    .UART_CLKS_PER_BIT(CLKS_PER_BIT)
  ) dut (
    .clk(clk),
    .rst_n(rst_n),
    .uart_rx(uart_rx),
    .uart_tx(uart_tx)
  );

  initial begin
    clk = 0;
    forever #(CLK_HALF_PERIOD) clk = !clk;
  end

  initial begin
    rst_n = 0;
    #2;
    rst_n = 1;
  end

  // serial transmitter: what the program reads
  integer rx_char;
  integer rx_bit;
  initial begin
    uart_rx = 1;
    repeat (RX_DELAY) @(negedge clk);
    for (rx_char = 0; rx_char < RX_LENGTH; rx_char = rx_char + 1) begin
      uart_rx = 0; // start
      repeat (CLKS_PER_BIT) @(negedge clk);
      for (rx_bit = 0; rx_bit < 8; rx_bit = rx_bit + 1) begin
        uart_rx = RX_STRING[(RX_LENGTH - 1 - rx_char) * 8 + rx_bit];
        repeat (CLKS_PER_BIT) @(negedge clk);
      end
      uart_rx = 1; // stop, then the gap
      repeat (CLKS_PER_BIT * (1 + RX_GAP)) @(negedge clk);
    end
  end

  // serial receiver
  reg [7:0] received [0:255];
  integer count;
  integer bit_index;
  initial begin
    count = 0;
    forever begin
      @(negedge uart_tx);
      repeat (CLKS_PER_BIT + CLKS_PER_BIT / 2) @(posedge clk);
      for (bit_index = 0; bit_index < 8; bit_index = bit_index + 1) begin
        received[count][bit_index] = uart_tx;
        repeat (CLKS_PER_BIT) @(posedge clk);
      end
      count = count + 1;
    end
  end

  // an interrupt must pre-empt the instruction completely: no data transfer in the cycle it is taken
  integer irq_with_transfer;
  initial irq_with_transfer = 0;
  always @(posedge clk) begin
    if (rst_n && dut.core_inst.trap_interrupt && dut.core_inst.trap && (dut.mem_read || dut.mem_write)) begin
      irq_with_transfer <= irq_with_transfer + 1;
    end
  end

  integer cycles;
  integer ok;
  initial begin
    cycles = 0;
    while (count < LENGTH && cycles < MAX_CYCLES) begin
      @(posedge clk);
      cycles = cycles + 1;
    end
    ok = (count == LENGTH) && (irq_with_transfer == 0);
    for (int c = 0; c < LENGTH && c < count; c = c + 1) begin
      if (received[c] !== EXPECTED[(LENGTH - 1 - c) * 8 +: 8]) ok = 0;
    end
    if (ok) begin
      $display("PASS: %0d characters in %0d cycles", count, cycles);
    end else begin
      $display("FAIL: expected %0d characters, got %0d (%0d interrupts taken with a data transfer)",
               LENGTH, count, irq_with_transfer);
      for (int c = 0; c < count; c = c + 1) $display("  [%0d] 0x%02x", c, received[c]);
    end
    $finish;
  end

endmodule
