dotayush/lucknow/(commit log)

2025-08-18 chore: lw instruction decoded correctly
    [decoder.sv, regfile.sv, shared.sv, test_decoder.sv]
2025-08-18 chore: fix memory alignment problem
    [control.sv, decoder.sv, memory.sv]
2025-08-19 chore: fix test and a signextender oopsie
    [signext.sv, test_decoder.sv, test_signext.sv]
2025-08-22 fix: remove jal display
    [decoder.sv]
2025-08-22 fix: implement the last three instructions for minimal core
    [control.sv, decoder.sv, shared.sv]
2025-08-24 chore: move minimal core L0 inside and fix a small signext oopsie
    [alu.sv, control.sv, csrfile.sv, decoder.sv, memory.sv, regfile.sv, shared.sv, signext.sv]
2025-08-25 chore: not a fan of mret handling
2026-10-11 feat(k0): split instruction and data ports with handshakes and core stalls
    The instruction cache moves out of the core: fetch is an imem_* port
    and the data port gains mem_ready. The core stalls (no pc, register,
    csr or trap update) while a fetch or data access is not ready and only
    issues a data request once its instruction has arrived, so a transfer
    happens exactly once. Reset vector is a RESET_VECTOR parameter.
    Claude-Session: https://claude.ai/code/session_01QziJUfavLUDtoVAnzXohvp
2026-10-11 feat(k0): bus with boot rom, ram and wait states, soc top
    One memory map for both ports: boot rom @0x1000 (reset vector, jumps to
    the ram) and ram @0x8000_0000. Unmapped accesses and stores to the rom
    are access faults. FETCH_WAIT/DATA_WAIT model slow memories and a store
    lands once, on the edge that completes it. soc.sv wires core and bus.
    Replaces the arbiter sketch. test_bus covers the map, faults, unified
    view and wait states, test_control runs a program on a fast and a slow
    soc and requires the same result.
    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
2026-10-11 fix: use always @* in control, iverilog rejects constant selects in always_comb
    Every simulation printed 'sorry: constant selects in always_* processes
    are not currently supported'. Both blocks are fully defaulted and
    publish their feedback signals once, so a plain always @* is equivalent.
    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
2026-10-11 feat(k0): transmit only uart with a 16550 register layout
    Byte registers at offsets 0..7 (THR, IER, IIR, LCR, MCR, LSR, MSR, SCR),
    8N1 serial output at clk/CLKS_PER_BIT. LSR reports THRE/TEMT, a byte
    written while busy is dropped. That is what the ns16550a driver and
    earlycon need for console output. test_uart decodes the serial line and
    checks register behaviour, frame timing, dropped writes and all-zero /
    all-one frames.
    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
2026-10-11 feat(k0): a extension (lr.w, sc.w and the nine word amos)
    An amo is two transfers of one instruction, sequenced by the core with
    its stall mechanism: read the old value, then write the new one (the
    alu does add/xor/and/or/min/max). lr sets a one word reservation, sc
    succeeds only for the same address, any store, sc, amo, trap or mret
    clears it. misa advertises A. A misaligned sc faults even when it would
    fail, faulting lr reports as a load and sc/amo as a store/amo.
    test_decoder, test_control (success, failed sc, other address, store
    killing the reservation, signed/unsigned min, same result on a slow
    soc) and test_amo_faults (misaligned, read only rom, unmapped: cause,
    mtval, rd and memory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
2026-10-11 feat(k0): uart on the data port at 0x1000_0000
    Byte accesses only (word and halfword accesses are access faults), the
    registers repeat inside a 256 byte window, a register write lands once,
    on the edge that completes the transfer. soc.sv exposes uart_tx and
    UART_CLKS_PER_BIT / UART_ECHO. test_bus covers the window edges,
    faulting widths without side effects and the write under wait states.
    The unmapped address used by test_amo_faults moves to 0x2000_0000.
    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
2026-10-11 feat(k0): bare-metal hello over the uart
    programs/hello.S polls LSR.THRE and prints a string, programs/run.sh
    builds a program and test_hello checks the characters on the serial
    line (a wrong character fails it).
    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
2026-10-11 docs: a extension, uart and the bare-metal program runner
    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
2026-10-11 feat(k0): machine timer and software interrupts, 64 bit counters
    interrupts are taken between instructions (the interrupted one is replayed after mret),
    mip/mie/mstatus.MIE, mtvec direct and vectored, mcycle/minstret with h halves,
    cycle/instret/time aliases, mstatus masked to MIE/MPIE/MPP. rv32mi illegal and
    instret_overflow now run for k0 through RV_MI_EXTRA.
    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
2026-10-11 test(k0): timer and irqatomic programs, expect files, slow memory runs
    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
2026-10-11 docs: clint, interrupts, counters and the new programs
    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
2026-10-11 feat(k0): uart receiver, line status and interrupts
2026-10-11 feat(k0): machine external interrupt (mip.MEIP)
2026-10-11 feat(k0): uart receive and plic on the bus, uart_rx on the soc
2026-10-11 test(k0): uartrx program, typed input through the runner
2026-10-11 docs: uart receive, plic and external interrupts
2026-10-11 docs(k0): chip overview, memory map, devices, interrupts
2026-10-11 feat(k0): boot rom passes the hart id in a0 and the device tree address in a1
2026-10-11 feat(k0): verilator model with image loading and uart console
2026-10-11 feat(k0): linux nommu build: device tree, defconfig, flat init and shell, build and run scripts
2026-10-11 feat(k0): 16550A fifos in the uart: 16 byte rx and tx, trigger levels, character timeout, FCR
2026-10-11 docs(k0): uart fifos, ns16550a, plan status
2026-10-11 feat(k0): 16 MiB ram in the model and device tree, busybox needs a contiguous 1 MiB
2026-10-11 feat(k0): interactive terminal on the uart, linux/shell.sh
2026-10-11 feat(k0): pc trace diff against QEMU, PMP and trace diff in the docs
2026-10-11 docs(k0): the printk difference is a likely cause, not a verified one
2026-10-11 feat(k0): pc trace comparison against QEMU, qemu console window
2026-10-16 build(eda): environment, setup, make shim and nixrun for the sky130 flow
    env.sh puts the EDA tools, the sky130 PDK and aicex on the path. PDK_ROOT has no
    trailing slash (ngspice before 40 reads // as a comment) and oss_cad comes ahead of
    the system tools, like in ~/.zshrc.
    make.shim forces bash for make: Wulff's makefiles write tcl with echo -e, which dash
    prints literally, so drc reports a false FAIL.
    nixrun.sh runs OpenROAD, KLayout, Yosys, Magic, Netgen and librelane from the nix store
    copied out of the librelane image, through bwrap, no root and no docker. It clears
    LD_LIBRARY_PATH, otherwise the host glibc is loaded and every binary segfaults.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
2026-10-16 feat(eda): ms_demo, an analog macro inside a digital design through librelane
    LELO_GR02 (an oscillator, magic layout) becomes a macro in a small counter and
    synchroniser. run.sh exports lef and gds from magic and makes the macro acceptable
    to the flow: pins marked POWER and GROUND in the lef, a prBoundary (235/4) in the gds,
    and a pdn script that also connects the macro grid down to met3.
    Ends with every signoff count at 0 (magic and klayout drc, lvs, antenna, routing,
    setup and hold at 20 MHz) and prints PASS.
    Claude-Session: https://claude.ai/code/session_01Xgt6pHu7SgLCGaeFC3BDtZ
2026-10-16 test(eda): verify.sh checks the whole setup from a clean environment
    Tool resolution and versions, the pdk, the make shim, the analog flow in a copy
    (gds, drc, lvs, extraction, simulation against the committed 2024 result, klayout
    rule deck), the ciccreator library, the committed sar9b layout, the native librelane
    smoke test, the dotfiles symlink and the l0 rtl commands. --gui opens the magic and
    xschem windows, --full also runs ms_demo.
    Every run needs a new directory; nothing is deleted.
    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
2026-10-16 docs(eda): analog, digital and mixed signal flows with what was verified
    Commands per domain, the results of each check, and the caveats found: leaf cells fail
    standalone lvs in the generated libraries, a regenerated sar9b fails pin matching,
    and two committed reference results (2022 schematic typical, 2026 oscillator
    frequency) could not be reproduced.
    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
2026-10-18 feat(l0): FPGA view of l0_core with yosys and nextpnr-ecp5
    fpga/run.sh synthesizes l0_core for a Lattice ECP5 (yosys with the slang front end) and places it with nextpnr-ecp5
    with no pin constraints, giving LUT counts and an fmax estimate in a few minutes. FPGA.md records the result:
    6351 LUT4, 1408 flip-flops, no RAM inferred (the register file has an async reset), and the same longest path as in
    the ASIC flow, instruction input to register through decode, register read, ALU and trap logic.
    It also records that yosys' built-in SystemVerilog reader drops `import isa_shared::*` and gives a count about 20%
    too high; the slang front end must be used for core/l0 and soc/k0.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
2026-10-18 feat(eda): view.sh opens runs in klayout, openroad and magic, with OpenGL for the 3D view
    KLayout showed layer numbers because it was not given the PDK's layer properties, and openroad -gui given an .odb
    tried to run the database as a Tcl script. view.sh loads the sky130A layer names and colors in KLayout, reads the
    database through a script in OpenROAD, and opens Magic with the PDK rc.
    The KLayout built in the nix store cannot reach the host graphics driver, so its 3D viewer aborted in
    QGLXContext::init. nixrun.sh takes NIXRUN_GL=1 to put a folder of links to the host NVIDIA libraries on
    LD_LIBRARY_PATH inside the sandbox; view.sh sets it for klayout. The links are created under $EDA/tools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
2026-10-18 perf(k0): keep the late branch decision out of the register file and the CSR writes
    Same change as in l0, adapted to k0's core. trap_early covers interrupts, fetch and pmp faults, decode, memory errors and
    misaligned jal, jalr and mret targets; a taken branch to a misaligned target is the late part. A stalled instruction clears both.
    The register file and the CSRs a trap does not touch (counters, pmp, mie, mtvec, mscratch, mcounteren) use trap_early. The
    branch taken and not taken events of the performance counters now read the branch decision (br_taken) directly; before, a taken
    branch to the next instruction counted as not taken.
    Verified on the final state: 13 unit tests, riscv-tests 74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
2026-10-18 feat(l0): LibreLane flow for l0_core with realistic constraints
    config.json hardens l0_core with the slow delay-type cells kept out of buffering. l0.sdc replaces LibreLane's generic constraint
    (20% of the clock on every port), which hid the real path: it models the memory as an access time and cuts the cycle at the
    ports, and marks the structural dmem_rdata to dmem_wdata path false (a load never writes memory). run.sh starts a full run on
    the SSD and links it into runs/, which is ignored by git. segments.sh measures the delay of each piece of the cycle on a
    finished run. screen.sh previews an RTL change by synthesis alone, about a minute, using ideal wires.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
2026-10-18 docs(l0): what the LibreLane runs showed and the model behind the timing
    RUNS.md records each try that finished or taught something (settings, results, outcome, path segments) and what was learned,
    so the run folders, about 1.8 GB each, can be deleted once recorded; results/ keeps each run's metrics.json. TIMING.md is the
    model: one cycle goes through the memory twice, where the time goes inside the core, the flow pitfalls found (default I/O
    constraint, wire estimate about 9 ns optimistic, hold buffers from a margin, rst_n delay), what the trap split changed, what
    could change the clock next, and why l0.sdc does not use the OpenRAM macro timing (analytical, nominal corner, synchronous read).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
2026-10-18 docs(eda): the digital flow as it works now, and verify.sh checks it
    verify.sh and eda_flows.md still described l0 as it was: control as the top, memory.sv as a blackbox, "l0 config not written yet".
    verify.sh now lints l0 (control with its memories), synthesizes l0_core with yosys and the slang front end (yosys' own reader
    drops the package import), and checks that l0_core has its 12 ports. eda_flows.md lists the verified commands: run.sh,
    segments.sh, screen.sh and view.sh, and why each exists.
    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
2026-10-18 refactor(eda): one eda.sh and a .env instead of the eda/ folder
    eda.sh is sourced for the environment and run for install, verify, view and shell (menu without arguments). .env (template .env.example) points at the tools directory and picks the PDK family; the tools and the PDK table are in eda.sh, so no tracked file names a machine path. docs/tool_paths.md becomes TOOLS.md, docs/eda_flows.md becomes FLOWS.md, the mixed signal demo and the other eda/ scripts are removed. xschem and the riscv gcc live under $EDA.
    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
2026-10-18 feat(l0): the LibreLane flow reads the PDK from .env
    run.sh, screen.sh and segments.sh take the PDK variant, standard cell library, slow corner and delay cells from the environment, and l0.sdc takes the driving cell from it, so the flow does not change when PDK_FAMILY does. sky130 reproduces the recorded screen numbers exactly; gf180mcuD synthesizes l0_core with the same scripts.
    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
2026-10-19 feat(eda): ihp-sg13g2 and PDK-relative l0 constraints
    PDK table gets ihp-sg13g2, the driving pin, and PDK_FO4_PS (fo4.sh measures
    it). l0.sdc scales its memory budgets, uncertainty and transition by the FO4
    ratio to sky130, so every PDK gets the same constraints in gate delays. The
    liberty and LEF paths are found by pattern (PDKs name them differently),
    PDK versions follow what LibreLane pins, screen.sh takes SCREEN_CFG, and
    segments.sh falls back to the nominal extraction.
    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
2026-10-19 docs(l0): t20 and the same core on IHP and gf180mcu
    t20: decode out of the register read, adder types are not the lever.
    t24, t25: one full flow per PDK, compared at each slow corner in ns and FO4.
    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
2026-10-19 feat(k0): div, divu, rem and remu run one bit per clock
    core/divider.sv is a restoring divider on the absolute values; control.sv
    starts it and holds the core with the same stall as a slow memory (34 clocks
    per divide: load, 32 bits, retire). An interrupt abandons it and it runs
    again after mret. The multiplies stay in the ALU, in one clock. The divide
    vectors of test_alu.sv moved to test_divider.sv, which also checks the clock
    count and two divides back to back. riscv-tests 74/74 (also with wait
    states), programs PASS, linux boot test PASS. Ideal-wire preview of the core
    path: 83 ns with the single-cycle divider, 15 ns now (AREA 3).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
